micked99/ICT-v4-ATGM336/README.md

# ICT-v4 - ATGM336
ICT-v4 Using the ATGM336 Gps
