micked99/ICT-v4-ATGM336/ict_v361-xs.brd

## EAGLE design ict_v361-xs.brd (2020-11-06, last stored version)

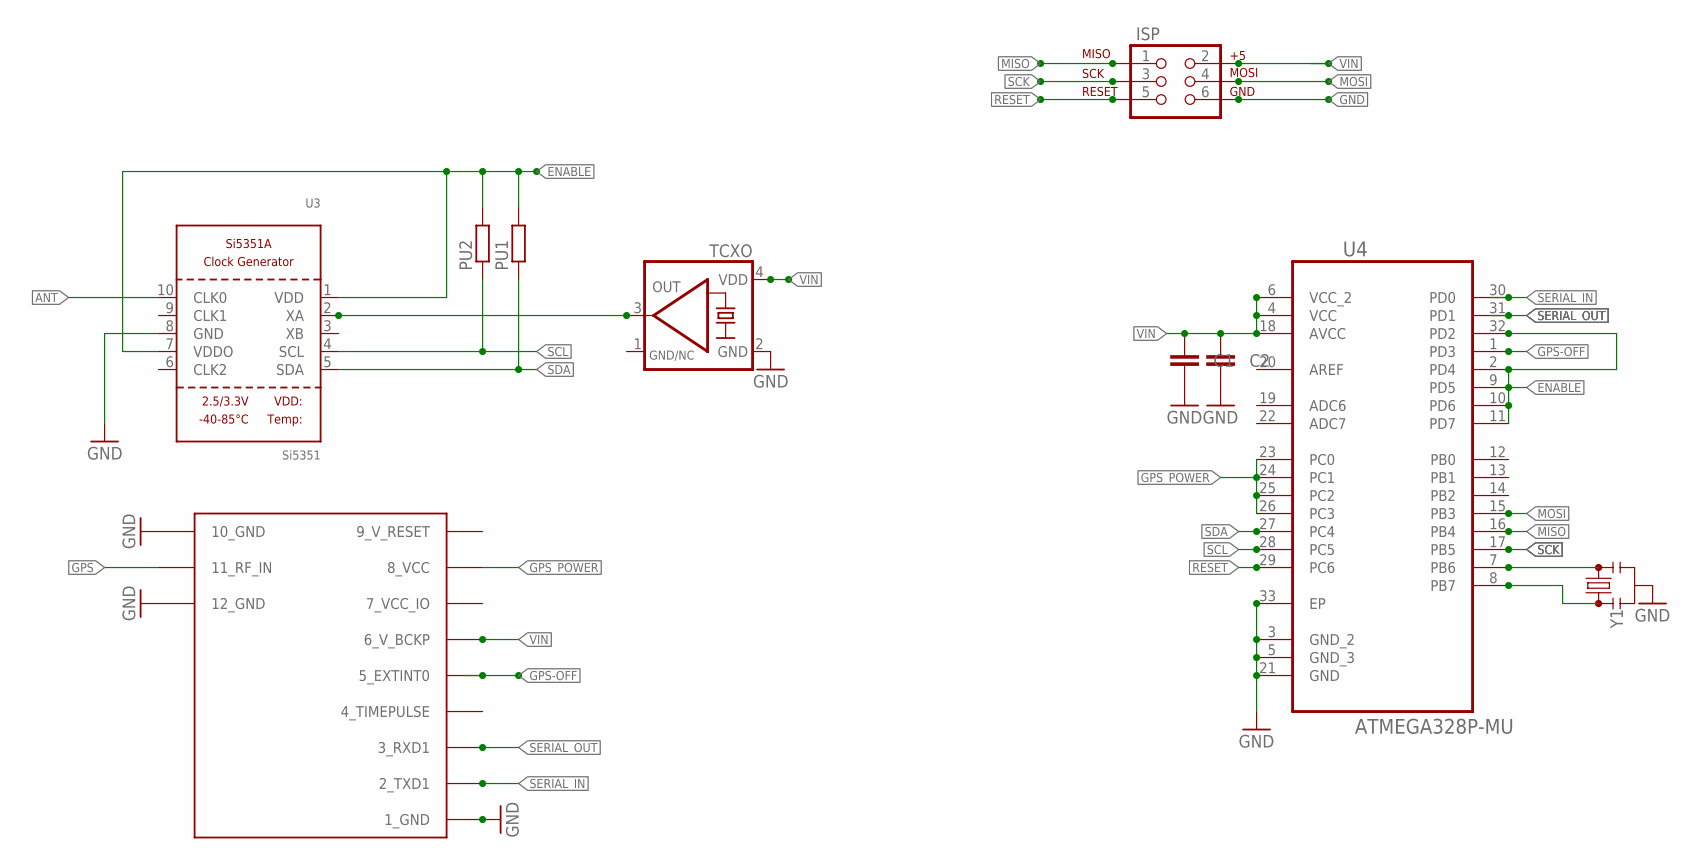
[picture p1: schematic ict_v361-xs.sch, WSPR tracker]

Parts:
C1, C2: C-EUC0603K; C0603K
ISP: AVR_SPI_PRG_6PTH; 2X3
PU1, PU2: R-EU_R0603; R0603
TCXO: KXO-TCXO-CMOS-84; 3.2X2.5_KXO-84-TCXO
U3: Si5351; MSOP10
U4: ATMEGA328P-MU; QFN50P500X500X100-33N
U$2: UBLOX_MAX
Y1: RESONATORSMD-4.5X2.0; RESONATOR-SMD-4.5X2.0

Connections:
7_VCC_IO: U$2.7_VCC_IO
9_V_RESET: U$2.9_V_RESET
ANT: U3.10 (CLK0)
ENABLE: PU1.2, PU2.2, U3.1 (VDD), U3.7 (VDDO), U4.2 (PD4), U4.9 (PD5), U4.10 (PD6), U4.11 (PD7), U4.32 (PD2)
GND: C1.2, C2.2, ISP.6, TCXO.2 (GND), U3.8 (GND), U4.3 (GND_2), U4.5 (GND_3), U4.21 (GND), U4.33 (EP), U$2.1_GND, U$2.10_GND, U$2.12_GND, Y1.2
GND/NC: TCXO.1 (GND/NC)
GPS: U$2.11_RF_IN
GPS-OFF: U4.1 (PD3), U$2.5_EXTINT0
GPS_POWER: U4.23 (PC0), U4.24 (PC1), U4.25 (PC2), U4.26 (PC3), U$2.8_VCC
MISO: ISP.1, U4.16 (PB4)
MOSI: ISP.4, U4.15 (PB3)
unnamed: U4.7 (PB6), Y1.3
unnamed: U4.8 (PB7), Y1.1
unnamed: TCXO.3 (OUT), U3.2 (XA)
RESET: ISP.5, U4.29 (PC6)
SCK: ISP.3, U4.17 (PB5)
SCL: PU2.1, U3.4 (SCL), U4.28 (PC5)
SDA: PU1.1, U3.5 (SDA), U4.27 (PC4)
SERIAL_IN: U4.30 (PD0), U$2.2_TXD1
SERIAL_OUT: U4.31 (PD1), U$2.3_RXD1
VIN: C1.1, C2.1, ISP.2, TCXO.4 (VDD), U4.4 (VCC), U4.6 (VCC_2), U4.18 (AVCC), U$2.6_V_BCKP

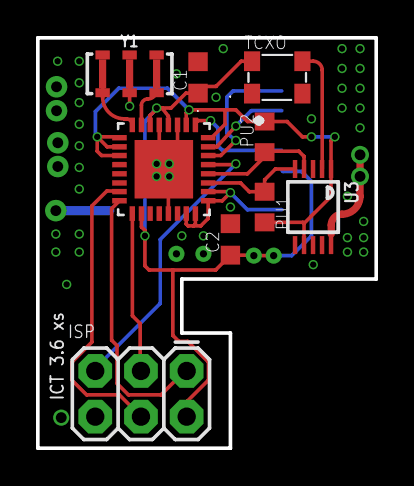
[picture p2: board ict_v361-xs.brd from above]

Board: 2 copper layers, 18.8 x 22.8 mm, 10 parts (1 on the bottom side), 16 nets.
